yiannosparanomos/gaggia-control-and-log/docs/README.md

# Docs

| Page | Read it for |
|---|---|
| [hardware.md](hardware.md) | Parts, wiring, the inside of the machine, the button-board repair |
| [architecture.md](architecture.md) | How everything fits together, from overview to details, with diagrams |
| [api.md](api.md) | HTTP routes and stored data |
| [development.md](development.md) | Building, testing and uploading, and the problems you're likely to hit |
| [decisions.md](decisions.md) | Why the project is built the way it is |
| [roadmap.md](roadmap.md) | Current status and planned work |
| [history.md](history.md) | How the project got here, from April 2026 |
| [legacy/](legacy/README.md) | The removed scale: its code, wiring and notes. Not built by PlatformIO |

Known bugs and cleanup are in [`todo.md`](../todo.md).
