yiannosparanomos/gaggia-control-and-log/docs/roadmap.md

# Roadmap

Known bugs are in [`todo.md`](../todo.md). This page covers status and planned work.

## Status

| Piece | State |
|---|---|
| Firmware | Start and stop through the relay, auto-stop at 5–60 s, 60 s safety stop, journal and coffees on LittleFS. Running on the real ESP32 and updated over WiFi. A few checks are still open in `todo.md` |
| Web app | **timer.**, **journal.** (list and calendar) and **coffees.** tabs, a log form with six taste scales, backup and restore, and an optional text-only Mistral chat |
| Relay and machine | COM and NO wired to PB1, with real shots run through the machine from the app |
| Demo | The app beside a simulated machine, published to GitHub Pages from `main` |

## Planned work

Roughly in order.

1. **MCP server** on the PC, talking to the ESP32 API, so Claude can read the journal, analyse shots
   and suggest dial-in changes. It gets read and log tools only: **no tool that starts the pump**
   without a human at the machine. The design is still to be discussed. Follow-ups are in `todo.md`.
2. **Finish the API redesign.** POST for actions is done. Still to do: `PUT /api/settings`,
   `DELETE /api/brews/{id}`, ArduinoJson for parsing and validation, an OpenAPI spec as the source of
   truth, and SSE or WebSocket for the live timer instead of polling every 300 ms.
3. **Cloud sync** of brews and coffees. The backend isn't chosen. Options to discuss first: a small
   FastAPI service, Supabase or Google Sheets.
4. **Sense the pump's state** through proper isolation, which fixes the top bugs in `todo.md`. See
   [development.md](development.md#the-esp32-cant-see-the-machine).
5. **Enclosures for the ESP32 and relay**, keeping low voltage physically apart from mains.

A scale is future hardware, to revisit later: see [`todo.md`](../todo.md#future-hardware).

## Related project: the machine's enclosure

A concrete-look enclosure around the machine, in OSB and microcement, with the machine's buttons and
lights moved to separate toggle switches on the top or side, and water fed by a tube. It's outside this
repo, but driving the machine's buttons and LEDs from new controls would fit with this ESP32.
