yiannosparanomos/gaggia-control-and-log/docs/images/u1-74hc244.jpg

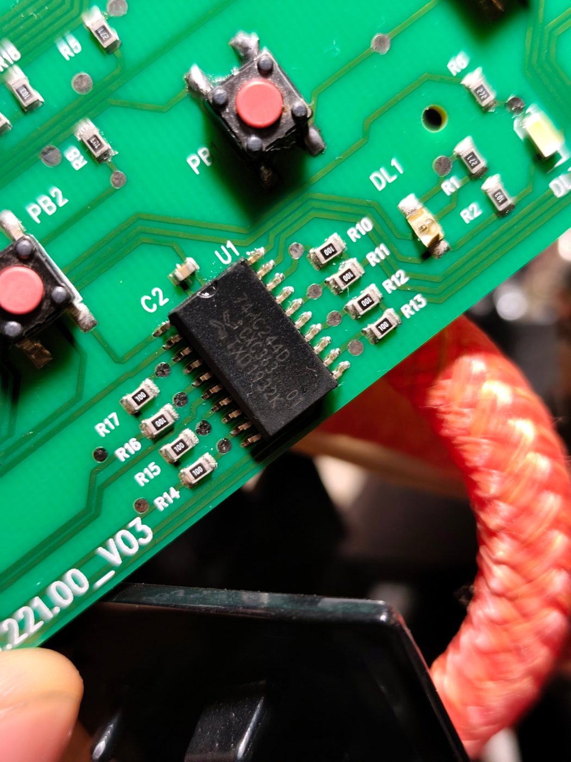
docs/images/u1-74hc244.jpg
