yiannosparanomos/gaggia-control-and-log/(commit log)

2026-11-05 Add npm run check and browser tests
    One command runs the private-file guard, UI build, size limits, browser
    tests against a fake ESP32, and the firmware compile. An optional
    npm run test:ui checks phone layouts and saves screenshots. It found the
    delete links were too small to tap, so they get more padding.
2026-11-05 Move shot rules to shot.h, test them on a PC, add WiFi updates
    The rules that decide when the relay may press now have no Arduino code,
    so 13 tests run on a PC with pio test -e native. ArduinoOTA adds WiFi
    uploads, never during a shot, because an update blocks loop(). It takes
    flash to 93.0%, so the size limit moves to 97% and todo.md flags it.
    Also pins the platform version.
2026-11-05 Add npm run flash, which backs up the journal before uploading
    Stops if the ESP32 is unreachable or brewing, or if the backup fails. It
    then builds, uploads over WiFi or USB, and confirms the journal kept all
    its brews. It also reads firmware with the old routes, for the first
    upload. Tests cover the safety checks.
2026-11-05 Add docs check, command guard and review subagents
    A commit-msg hook blocks code changes that arrive without their docs,
    compares the API table with the firmware and checks links, with no AI.
    CI repeats it on pull requests. A Claude Code hook blocks commands that
    would wipe the journal, stage private files or skip git hooks. Two
    subagents handle safety reviews and doc updates. Architecture section 6
    explains how it fits together.
2026-11-05 Fix safety review findings
    The app now sends confirm=1 on reset only after really asking, so a stale
    screen can't end a running shot's stops. Journal reads and deletes wait
    until a shot ends, because sending them could block the stops. Flash
    checks the state again just before uploading. A failed WiFi update
    restarts, dropping any start tapped during it. Saving and deleting brews
    now verify the result, and the relay pin is set up first thing at boot.
    [main.cpp]
2026-11-06 Fix review findings in journal deletes, saves and the flash command
    - Delete now checks every line it reads. The earlier check could never fire.
    - Saves are refused below 8 KB free, with a clear message, because a cut-off
    brew would make the whole journal unreadable.
    - During a shot the app no longer says the journal is empty, hides the
    backup link, and explains why a delete was refused.
    - The flash command compiles and uploads the same target, and now has tests
    for that and for the check before uploading.
    Docs-Checked: flash steps and test commands are unchanged
    [main.cpp]
2026-11-06 Move to a custom partition table with more firmware space
    Each app slot grows from 1.25 MB to 1.5 MB and the journal storage shrinks
    from 1.375 MB to 896 KB. The firmware drops from 95% to 79% of its slot.
    This wipes the journal once: the steps are in todo.md and development.md.
    - check and WiFi uploads refuse FORMAT_IF_MOUNT_FAILS = true.
    - The flash command saves no empty backups, which could hide a real one,
    and reports storage that did not mount.
    - Restore reads the current list first, so a retry can't duplicate brews,
    and no longer blames the file for connection errors.
    Docs-Checked: main.cpp only changed a comment, and web behaviour is covered in development.md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
    [partitions.csv]
2026-11-06 Put the first flash steps in one section of the development notes
    The ESP32 can stay wired to the machine as long as the machine is unplugged,
    so the steps no longer ask to disconnect the relay wires.
2026-11-06 Remove the scale from current docs and keep its notes in legacy
    The load cell has been removed from the machine. Its parts, wiring and
    calibration moved to docs/legacy/README.md, and the scale is now a future
    hardware item in todo.md. docs/history.md still records it as past events.
2026-11-06 State that the project is for home use by one device at a time
    The app sends the whole coffee list on each save, so two devices can
    overwrite each other. Add the limit to the README and decisions, and a
    much-later item to fix it.
2026-11-06 Show the timer's decimal point as a dot
    Doto draws the full stop as a small plus, so 12.4 read as 12+4. Leave that
    one character to Commissioner, and retake the README's demo picture.
    Docs-Checked: visual change only, with no change to behaviour or routes
2026-11-06 Draw the timer's decimal point as a square
    The round fallback dot looked out of place beside the dot-matrix digits. It is now a CSS square the size of a digit pixel, and the page text still reads 12.4.
    Docs-Checked: visual change to the timer only, and no doc describes the dot
2026-11-06 Add an optional Mistral chat and guard start after a sheet closes
    The phone calls Mistral directly with the user's own key, sending the visible tab and the last 5 brews. It has no tools, so a reply can't reach the machine, and replies are escaped before basic markdown is formatted. The ESP32 stays offline and never sees the key.
    A double-tap on a sheet's close button could land on start and run the pump, so start now ignores taps for 400 ms after a sheet closes. Stop is never delayed.
    The demo gains nine of the owner's real brews, at the owner's request. The docs record the exception, the model choice and the accepted risk of keeping a key on a plain HTTP page.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
